PJ789/Autonomous-Car/autonomous_car/index.md

Arduino IDE/Pico SDK autonomous car firmware for Raspberry Pico.

Includes multi-core Core0/Core1 code, servo motor control using PWM, DC motor control using PWM, ultrasound sensors.
