PJ789/Autonomous-Car/Autonomous Car Circuit Diagram.png

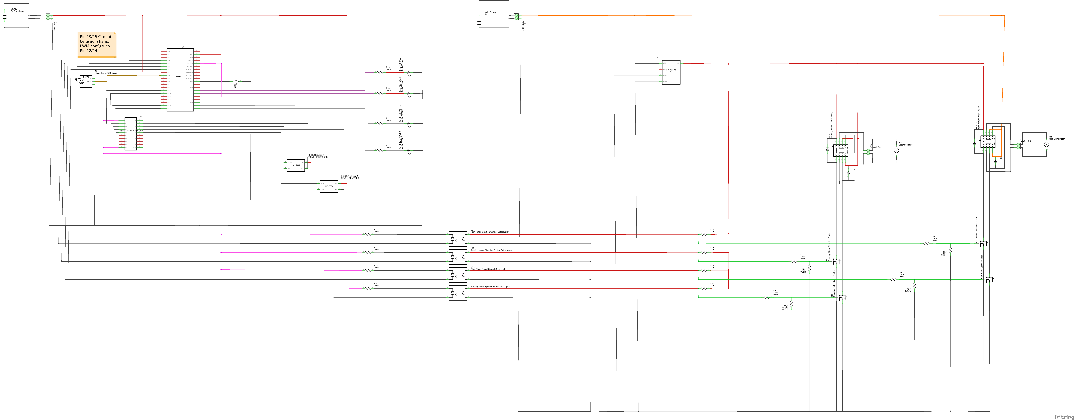
Autonomous Car Circuit Diagram.png
