PJ789/Autonomous-Car/autonomous_car/radar.h

#ifndef Radar_h
#define Radar_h

#include <stdint.h>
#include <algorithm>
#include <arduino.h>
#include <pico/multicore.h>
#include <pico/time.h>
#include "autonomous_car.h"
#include "Servo.h"
#include "Ultrasound.h"

 // brown wire - trigger
 // blue wire  - echo
 
#define FRONT_ULTRASOUND_TRIG_PIN       10
#define FRONT_ULTRASOUND_ECHO_PIN       11
// Avoid pin                            12
// Do not use pin                       13
#define REAR_ULTRASOUND_TRIG_PIN        14
#define REAR_ULTRASOUND_ECHO_PIN        15

#define RADAR_ACTIVE_PIN                8

#define RADAR_SERVO_MILLIS_PER_DEGREE   5
#define RADAR_SCAN_STEP_DEGREES        25

#define RADAR_MEASUREMENTS_GRANULARITY  5
#define RADAR_MEASUREMENTS              1+(180/RADAR_MEASUREMENTS_GRANULARITY) 

class Radar
{

  public:

    Radar();

    void Iterator();
    void     SetRadarActivePin();
    uint32_t MeasureFront();
    uint32_t MeasureRear();   
    Ultrasound front_ultrasound;
    Ultrasound rear_ultrasound;
   
  private:
    Servo                     radar_turret;
    steering_motor_direction  last_steering_motor_direction;
    drive_motor_direction     last_drive_motor_direction;
    uint8_t                   last_drive_motor_speed;

    void     TurretRotationSequencer();
    void     RotateTurret(int16_t);
    int8_t   GetTurretDirection();

    void     DataDebug();
    void     ServoDiagnostics();
    void     SetDriveMotorSpeed(      uint8_t );
    void     Drive(                   drive_motor_direction );
    void     Steer(                   steering_motor_direction );
    void     DecodeFifo(              uint32_t);
    int16_t  ConvertServoAngleToCarAngle(uint8_t);
    uint8_t  ConvertCarAngleToServoAngle(int16_t);

    bool Stopped();
    bool Moving();
    bool MovingForward();
    bool MovingBackward();
    bool DirectionIsForward();
    bool DirectionIsReverse();
    bool Turning();
    bool TurningLeft();
    bool TurningRight();

    void SendFifoDebugMessage(char*);
};



#endif
