PJ789/Autonomous-Car/(commit log)

2022-05-27 Fixes fault with turret sequencing, and improves core1 stability
    [autonomous_car.h, autonomous_car.ino, car.cpp, car.h, lights.h, radar.cpp, radar.h, servo.cpp]
2022-05-27 Fixed turret sequence bug and core1 stability issue
    [car.cpp, car.h, radar.cpp, ultrasound.cpp]
